edvard5/WLED-Controller/LED_Wled.kicad_pcb

## KiCad design LED_Wled.kicad_pcb (2023-08-01)

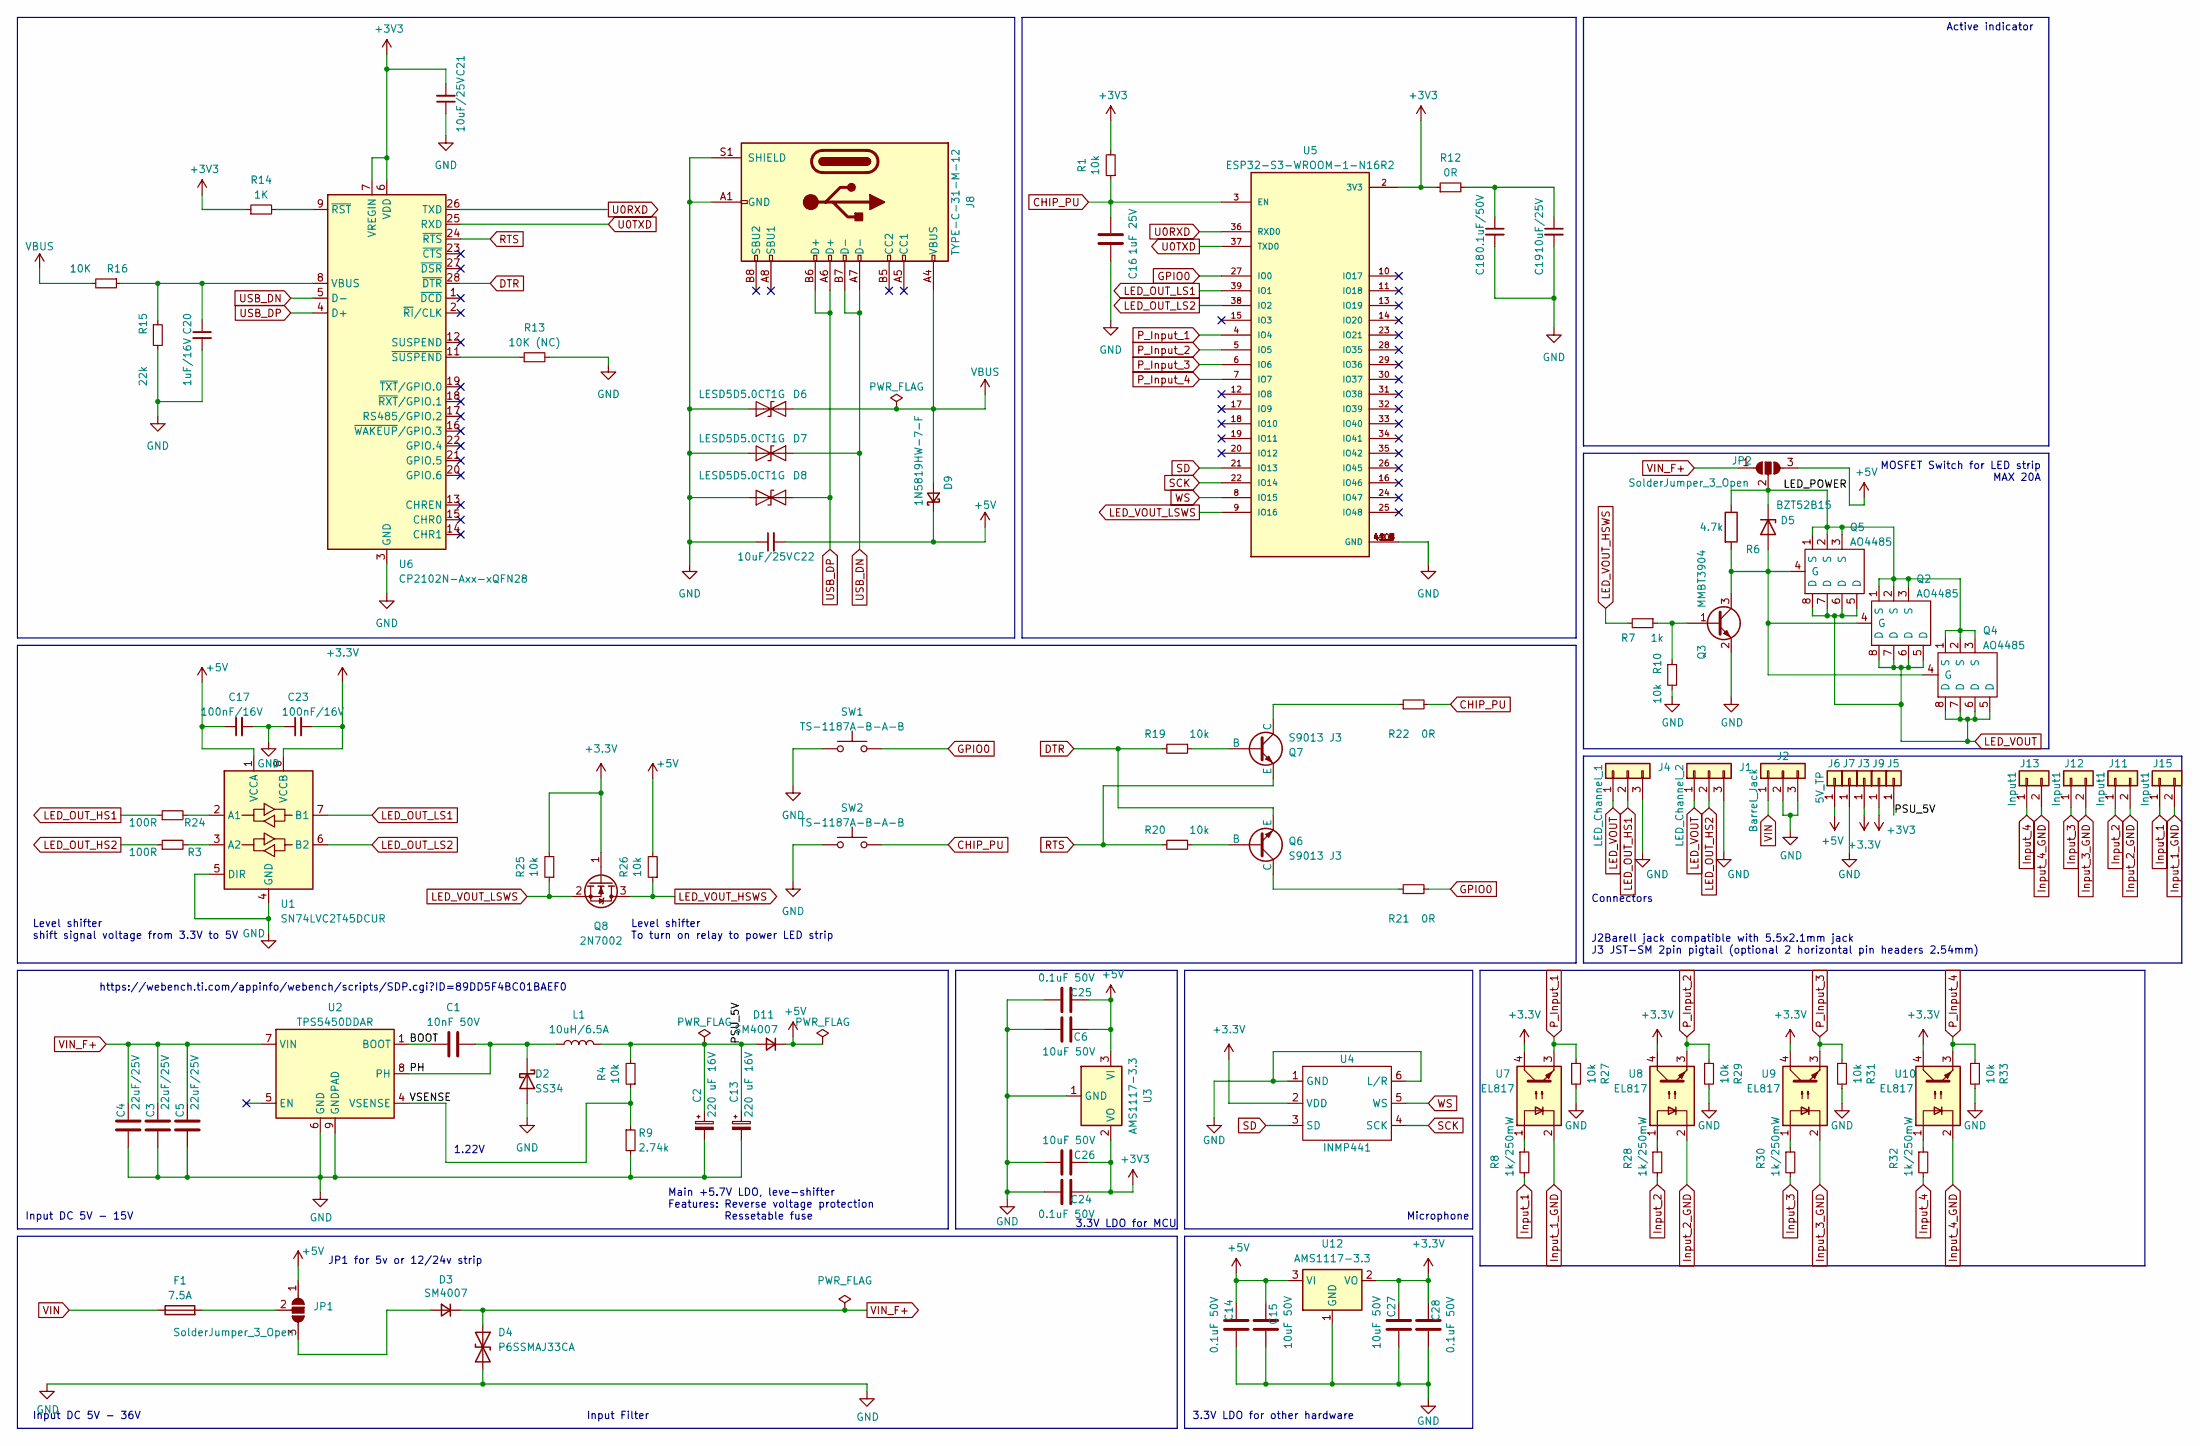
[picture p1: schematic LED_Wled.kicad_sch]

Parts:
C1: 10nF 50V; C_0603_1608Metric; MPN 0603B103K500NT; JLCSMT_PKG 0603
C2, C13: 220 uF 16V; CP_Elec_8x6.7; MPN OVZ151M1CTR-0807; JLCSMT C250068
C3, C4, C5: 22uF/25V; C_1206_3216Metric; MPN CL31A226KAHNNNE; JLCSMT C12891
C6, C15, C26, C27: 10uF 50V; C_1206_3216Metric; MPN CL31A106KBHNNNE; JLCSMT C13585
C14, C24, C25, C28: 0.1uF 50V; C_0603_1608Metric; MPN CC0603KRX7R9BB104; JLCSMT C14663
C16: 1uF 25V; C_0402_1005Metric_Pad0.74x0.62mm_HandSolder; MPN CL05A105KA5NQNC; JLCSMT C52923
C17, C23: 100nF/16V; C_0402_1005Metric_Pad0.74x0.62mm_HandSolder
C18: 0.1uF/50V; C_0402_1005Metric_Pad0.74x0.62mm_HandSolder
C19, C21, C22: 10uF/25V; C_0603_1608Metric_Pad1.08x0.95mm_HandSolder
C20: 1uF/16V; C_0402_1005Metric_Pad0.74x0.62mm_HandSolder
D2: SS34; D_SMA; MPN SS34; JLCSMT C8678
D3, D11: SM4007; D_SOD-123F; MPN SM4007PL; JLCSMT C64898
D4: P6SSMAJ33CA; D_SMA; MPN SMAJ26CA; JLCSMT C148226
D5: BZT52B15; D_SOD-123; MPN BZT52B15; JLCSMT C179512
D6, D7, D8: LESD5D5.0CT1G; D_SOD-523
D9: 1N5819HW-7-F; D_SOD-123
F1: 7.5A; Fuse_Blade_Mini_directSolder
J1: LED_Channel_2; JST_VH_B3P-VH_1x03_P3.96mm_Vertical; JLC_PART C703273
J2: Barrel_Jack; BarrelJack_Horizontal; MPN DC-005-20A; JLCSMT C136744
J3, J5, J6, J9: Conn_01x01; TestPoint_Pad_1.5x1.5mm
J4: LED_Channel_1; JST_VH_B3P-VH_1x03_P3.96mm_Vertical; JLC_PART C703273
J7: 5V_TP; TestPoint_Pad_1.5x1.5mm
J8: TYPE-C-31-M-12; USB_C_Receptacle_G-Switch_GT-USB-7010ASV; JLCPCB_PART C165948
J11, J12, J13, J15: Input1; JST_XH_B2B-XH-AM_1x02_P2.50mm_Vertical; JLC_PART C692532
JP1, JP2: SolderJumper_3_Open; SolderJumper-3_P2.0mm_Open_TrianglePad1.0x1.5mm_NumberLabels
L1: 10uH/6.5A; L_Wuerth_WE-PD2-Typ-XL; MPN BMRF00101040100MA1; JLCSMT C2903677
Q2, Q4, Q5: AO4485; SOIC-8_3.9x4.9mm_P1.27mm; MPN AO4485; JLCSMT C51499
Q3: MMBT3904; SOT-23; MPN MMBT3904; JLCSMT C20526
Q6, Q7: S9013 J3; SOT-23
Q8: 2N7002; SOT-23
R1, R4, R10, R19, R20, R25, R26, R27, R29, R31, R33: 10k; R_0805_2012Metric; MPN 0805W8F1002T5E; JLCSMT C17414
R3, R24: 100R; R_0805_2012Metric
R6: 4.7k; R_0603_1608Metric; MPN 0603WAF4701T5E; JLCSMT_PKG 0603
R7: 1k; R_0603_1608Metric; MPN 0603WAF2401T5E; JLCSMT C22940
R8, R28, R30, R32: 1k/250mW; R_1206_3216Metric_Pad1.30x1.75mm_HandSolder; JLC_PART C4410
R9: 2.74k; R_0603_1608Metric
R12, R21, R22: 0R; R_0805_2012Metric
R13: 10K (NC); R_0805_2012Metric
R14: 1K; R_0805_2012Metric
R15: 22k; R_0805_2012Metric
R16: 10K; R_0805_2012Metric
SW1, SW2: TS-1187A-B-A-B; SW_Push_1P1T_XKB_TS-1187A; JLC_PART C318884
U1: SN74LVC2T45DCUR; VSSOP-8_2.4x2.1mm_P0.5mm
U2: TPS5450DDAR; TI_SO-PowerPAD-8; MPN TPS5450DDAR; JLCSMT C114425
U3, U12: AMS1117-3.3; SOT-223-3_TabPin2; MPN AMS1117-3.3; JLCSMT C6186
U4: INMP441
U5: ESP32-S3-WROOM-1-N16R2; XCVR_ESP32-S3-WROOM-1-N16R2; PARTREV v1.0
U6: CP2102N-Axx-xQFN28; QFN-28-1EP_5x5mm_P0.5mm_EP3.35x3.35mm
U7, U8, U9, U10: EL817; SMDIP-4_W7.62mm; JLC_PART C106900

Connections:
+3.3V: C23.2, C27.1, C28.2, J3.1, Q8.1 (G), R25.2, U1.8 (VCCB), U4.2 (VDD), U7.4, U8.4, U9.4, U10.4, U12.2 (VO)
+3V3: C21.2, C24.2, C26.1, J9.1, R1.2, R12.1, R14.1, U3.2 (VO), U5.2 (3V3), U6.6 (VDD), U6.7 (VREGIN)
+5V: C6.1, C14.2, C15.1, C17.1, C22.2, C25.2, D9.1 (K), D11.1 (K), J6.1, JP1.1 (A), JP2.3 (B), R26.2, U1.1 (VCCA), U3.3 (VI), U12.3 (VI)
/BOOT: C1.2, U2.1 (BOOT)
/LED_POWER: D5.1 (K), JP2.2 (C), Q2.1 (S), Q2.2 (S), Q2.3 (S), Q4.1 (S), Q4.2 (S), Q4.3 (S), Q5.1 (S), Q5.2 (S), Q5.3 (S), R6.1
/PH: C1.1, D2.1 (K), L1.1, U2.8 (PH)
/PSU_5V: C2.1, C13.1, D11.2 (A), J5.1, L1.2, R4.2
/VSENSE: R4.1, R9.1, U2.4 (VSENSE)
CHIP_PU: C16.2, R1.1, R22.2, SW2.2, U5.3 (EN)
DTR: Q6.3 (E), R19.2, U6.28 (~DTR)
GND: C2.2, C3.1, C4.1, C5.1, C6.2, C13.2, C14.1, C15.2, C16.1, C17.2, C18.2, C19.2, C20.2, C21.1, C22.1, C23.1, C24.1, C25.1, C26.2, C27.2, C28.1, D2.2 (A), D4.2 (A2), D6.1 (A1), D7.1 (A1), D8.1 (A1), J1.3, J2.2, J2.3, J4.3, J7.1, J8.A1 (GND), J8.A12 (GND), J8.B1 (GND), J8.B12 (GND), J8.S1 (SHIELD), Q3.2 (E), R9.2, R10.2, R13.2, R15.2, R27.2, R29.2, R31.2, R33.2, SW1.1, SW2.1, U1.4 (GND), U1.5 (DIR), U2.6 (GND), U2.9 (GNDPAD), U3.1 (GND), U4.1 (GND), U4.6 (L/R), U5.1 (GND), U5.40 (GND), U5.41_1 (GND), U5.41_2 (GND), U5.41_3 (GND), U5.41_4 (GND), U5.41_5 (GND), U5.41_6 (GND), U5.41_7 (GND), U5.41_8 (GND), U5.41_9 (GND), U5.41_10, U5.41_11, U5.41_12, U5.41_13, U5.41_14, U5.41_15, U5.41_16, U5.41_17, U5.41_18, U5.41_19, U5.41_20, U5.41_21, U6.3 (GND), U6.29 (GND), U12.1 (GND)
GPIO0: R21.2, SW1.2, U5.27 (IO0)
Input_1: J15.1, R8.2
Input_1_GND: J15.2, U7.2
Input_2: J11.1, R28.2
Input_2_GND: J11.2, U8.2
Input_3: J12.1, R30.2
Input_3_GND: J12.2, U9.2
Input_4: J13.1, R32.2
Input_4_GND: J13.2, U10.2
LED_OUT_HS1: J4.2, R24.1
LED_OUT_HS2: J1.2, R3.1
LED_OUT_LS1: U1.7 (B1), U5.39 (IO1)
LED_OUT_LS2: U1.6 (B2), U5.38 (IO2)
LED_VOUT: J1.1, J4.1, Q2.5 (D), Q2.6 (D), Q2.7 (D), Q2.8 (D), Q4.5 (D), Q4.6 (D), Q4.7 (D), Q4.8 (D), Q5.5 (D), Q5.6 (D), Q5.7 (D), Q5.8 (D)
LED_VOUT_HSWS: Q8.3 (D), R7.2, R26.1
LED_VOUT_LSWS: Q8.2 (S), R25.1, U5.9 (IO16)
unnamed: C18.1, C19.1, R12.2
unnamed: D3.2 (A), JP1.3 (B)
unnamed: D5.2 (A), Q2.4 (G), Q3.3 (C), Q4.4 (G), Q5.4 (G), R6.2
unnamed: F1.2, JP1.2 (C)
unnamed: Q3.1 (B), R7.1, R10.1
unnamed: Q6.2 (B), R20.1
unnamed: Q6.1 (C), R21.1
unnamed: Q7.2 (B), R19.1
unnamed: Q7.1 (C), R22.1
unnamed: R8.1, U7.1
unnamed: R28.1, U8.1
unnamed: R30.1, U9.1
unnamed: R32.1, U10.1
unnamed: R24.2, U1.2 (A1)
unnamed: R3.2, U1.3 (A2)
unnamed: C20.1, R15.1, R16.1, U6.8 (VBUS)
unnamed: R14.2, U6.9 (~RST)
unnamed: R13.1, U6.11 (~SUSPEND)
P_Input_1: R27.1, U5.4 (IO4), U7.3
P_Input_2: R29.1, U5.5 (IO5), U8.3
P_Input_3: R31.1, U5.6 (IO6), U9.3
P_Input_4: R33.1, U5.7 (IO7), U10.3
RTS: Q7.3 (E), R20.2, U6.24 (~RTS)
SCK: U4.4 (SCK), U5.22 (IO14)
SD: U4.3 (SD), U5.21 (IO13)
U0RXD: U5.36 (RXD0), U6.26 (TXD)
U0TXD: U5.37 (TXD0), U6.25 (RXD)
USB_DN: D7.2 (A2), J8.A7 (D-), J8.B7 (D-), U6.5 (D-)
USB_DP: D8.2 (A2), J8.A6 (D+), J8.B6 (D+), U6.4 (D+)
VBUS: D6.2 (A2), D9.2 (A), J8.A4 (VBUS), J8.A9 (VBUS), J8.B4 (VBUS), J8.B9 (VBUS), R16.2
VIN: F1.1, J2.1
VIN_F+: C3.2, C4.2, C5.2, D3.1 (K), D4.1 (A1), JP2.1 (A), U2.7 (VIN)
WS: U4.5 (WS), U5.8 (IO15)

Notes on the sheet:
Microphone
3.3V LDO for other hardware
Main +5.7V LDO, leve-shifter Features: Reverse voltage protection Ressetable fuse
Level shifter shift signal voltage from 3.3V to 5V
Input Filter
Level shifter To turn on relay to power LED strip
Active indicator
J2Barell jack compatible with 5.5x2.1mm jack J3 JST-SM 2pin pigtail (optional 2 horizontal pin headers 2.54mm)
1.22V
MOSFET Switch for LED strip MAX 20A
Input DC 5V - 36V
Connectors
3.3V LDO for MCU
https://webench.ti.com/appinfo/webench/scripts/SDP.cgi?ID=89DD5F4BC01BAEF0
Input DC 5V - 15V
JP1 for 5v or 12/24v strip

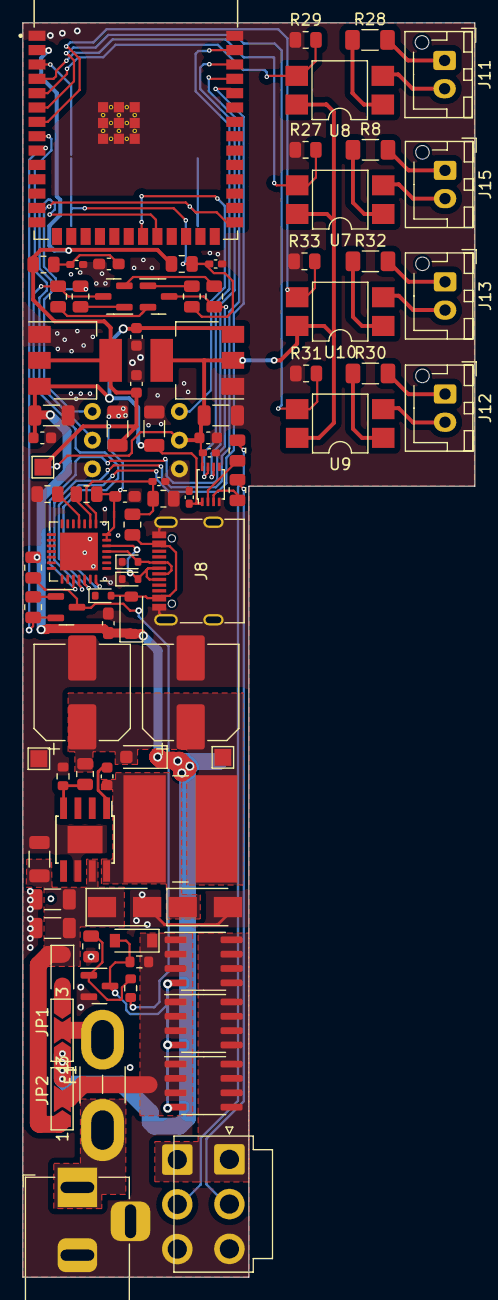
[picture p2: board LED_Wled.kicad_pcb from above]

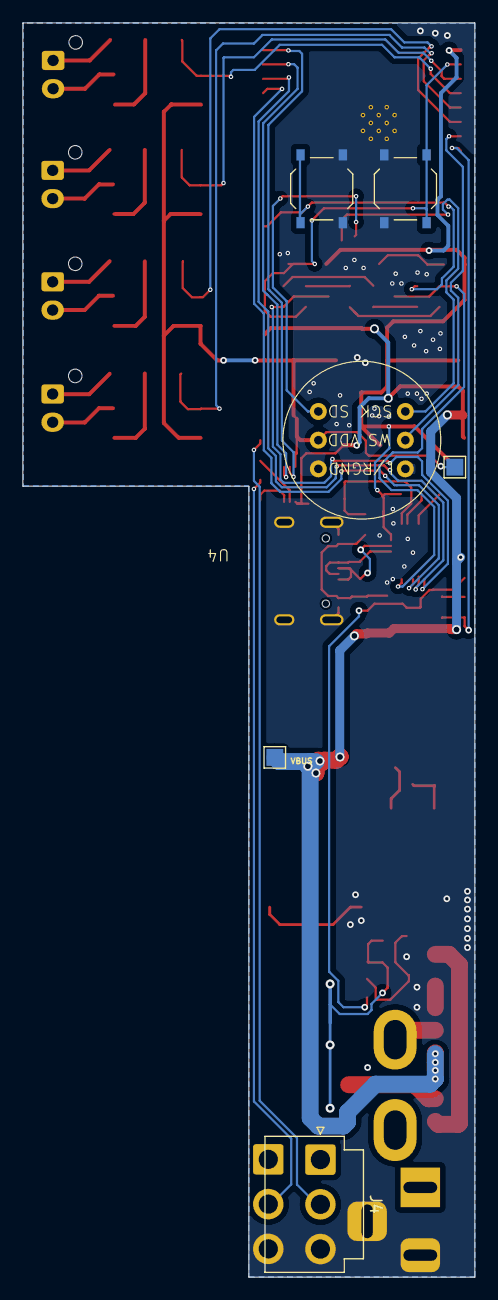
[picture p3: board LED_Wled.kicad_pcb from below]

Board: 2 copper layers, 40.0 x 111.0 mm, 95 parts (6 on the bottom side), 60 nets.
