edvard5/WLED-Controller/(commit log)

2022-07-20 init v2
    [LED_Wled.kicad_pcb, LED_Wled.sch]
2022-07-21 pcb drawn, changed components
    lm1117 to ams1117
    [LED_Wled.kicad_pcb, LED_Wled.sch]
2022-07-22 connector changes, pcb redesign
    added +5V output with switch with mosfet, changed level shifter from transistor to buffer 4chan, added 2 more led strip channels
    [LED_Wled.kicad_pcb, LED_Wled.sch]
2022-07-22 redrawn pcb from scratch rev2.0
    [LED_Wled.kicad_pcb, LED_Wled.sch]
2022-11-16 fixed +5v rail switch
    [LED_Wled.kicad_pcb, LED_Wled.sch]
2023-01-06 migration to kicad 6
    [LED_Wled.kicad_pcb, LED_Wled.kicad_sch]
2023-01-25 updated parts, rdy for production?
    [LED_Wled.kicad_pcb, LED_Wled.kicad_sch]
2023-07-27 rev2.1.0 WIP
    [LED_Wled.kicad_pcb, LED_Wled.kicad_sch]
2023-07-27 added couple of footprints
    [LED_Wled.kicad_sch]
2023-07-28 PCB design WIP
    [LED_Wled.kicad_pcb, LED_Wled.kicad_sch, LED_Wled.sch]
2023-07-31 removed power indicator LED, replaced some parts to basic
    [BOM-LED_Wled.csv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]
